IvanGrigorik/Diploma/Notes/Word/Титульный лист ДП.docx

Министерство образования Республики Беларусь

Учреждение образования

БЕЛОРУССКИЙ ГОСУДАРСТВЕННЫЙ УНИВЕРСИТЕТ

ИНФОРМАТИКИ И РАДИОЭЛЕКТРОНИКИ

Факультет компьютерных систем и сетей

Кафедра электронных вычислительных машин

| К ЗАЩИТЕ ДОПУСТИТЬ: Зав. каф. ЭВМ ___________Б.В. Никульшин

ПОЯСНИТЕЛЬНАЯ ЗАПИСКА

к дипломному проекту

на тему

АППАРАТНЫЙ КОМПЛЕКС ДЛЯ ГЕНЕРАЦИИ ШУМОВ НА ЧАСТОТАХ WI-FI И BLUETOOTH

БГУИР ДП 1–40 02 01 01 024 ПЗ

Студент Руководитель Консультанты: от кафедры ЭВМ по экономической части Нормоконтролер Рецензент | И.А. Григорик Д.В. Куприянова Д.В. Куприянова В.Г. Горовой Н.О. Туровец

МИНСК 2024
