IvanGrigorik/Diploma/Notes/Word/Титульный Лист ПДП.docx

Министерство образования Республики Беларусь

Учреждение образования

БЕЛОРУССКИЙ ГОСУДАРСТВЕННЫЙ УНИВЕРСИТЕТ

ИНФОРМАТИКИ И РАДИОЭЛЕКТРОНИКИ

Факультет компьютерных систем и сетей

Кафедра электронных вычислительных машин

Отчет по преддипломной практике

Студент И.А. Григорик

Руководитель Д.Ю. Перцев

Консультант от кафедры ЭВМ Д.В. Куприянова

Нормоконтролер Н.О. Туровец

МИНСК 2024
