IvanGrigorik/Diploma/Notes/PDF/Ведомость.pdf

Изм. Лист | | № докум. | Подп. | Дата
Разраб. | Григорик | | | Аппаратный комплекс для генерации шумов на частотах Wi-Fi и Bluetooth. Ведомость документов | Лит. | Лист | Листов
Пров. | Куприянова | | | | | У | | 1
Т. контр. | Куприянова | | | | ЭВМ, гр. 050503
Н. контр. | Туровец
Утв. | Никульшин

## БГУИР ДП 1–400201 01 024 Д1

Обозначение | Наименование | Примечание
| Графические документы
ГУИР.400201.024 ПЛ.1 | Вводный плакат. Плакат | А1
ГУИР.400201.024 ПЛ.2 | Основные определения и методы
| работы схожих устройств. Плакат | А1
ГУИР.400201.024 ПЛ.3 | Заключительный плакат. Плакат | А1
ГУИР.400201.024 Э1 ГУИР.400201.024 Э1 | Аппаратный комплекс для генерации Аппаратный комплекс для генерации
| шумов на частотах Wi-Fi и Bluetooth. шумов на частотах Wi-Fi и Bluetooth.
| Схема электрическая структурная Схема электрическая структурная | А1 А1
ГУИР.400201.024 Э2 ГУИР.400201.024 Э2 | Аппаратный комплекс для генерации Аппаратный комплекс для генерации
| шумов на частотах Wi-Fi и Bluetooth. шумов на частотах Wi-Fi и Bluetooth.
| Схема электрическая функциональная Схема электрическая функциональная | А1 А1
ГУИР.400201.024 Э3 ГУИР.400201.024 Э3 | Аппаратный комплекс для генерации Аппаратный комплекс для генерации
| шумов на частотах Wi-Fi и Bluetooth. шумов на частотах Wi-Fi и Bluetooth.
| Схема электрическая принципиальная Схема электрическая принципиальная | А1 А1
| Текстовые документы
БГУИР ДП БГУИР ДП 1–400201 01 400201 01 024ПЗ | Пояснительная записка Пояснительная записка | 96 с.
ГУИР.400201.024 ПЭ3 | Перечень элементов | 2 л., в ПЗ
ГУИР.400201.024 Э4 | Аппаратный комплекс для генерации
| шумов на частотах Wi-Fi и Bluetooth.
| Чертёж электромонтажный | А4, в ПЗ
| Аппаратный комплекс для генерации
| шумов на частотах Wi-Fi и Bluetooth.
| Чертёж электромонтажный.
| Спецификация | 1 л., в ПЗ
| Отзыв руководителя
| Отчет проверки на заимствования | 2 л.
| Рецензия
