IvanGrigorik/Diploma/Notes/PDF/Спецификация.pdf

Изм. Лист | | № докум. | Подп. | Дата
Разраб. | Григорик | | | Аппаратный комплекс для генерации шумов на частотах Wi-Fi и Bluetooth. Спецификация | Лит. | Лист | Листов
Пров. | Куприянова | | | | | У | | 1
Т. контр. | Куприянова | | | | ЭВМ, гр. 050503
Н. контр. | Туровец
Утв. | Никульшин

## ГУИР.400201.024 Д2

Обозначение | Наименование | Примечание
| Документация
51-01 | Программа и методика
| испытаний | В составе пояснительной записки
81-01 | Пояснительная записка

Компоненты
BOM.csv
Производственный файл | На DVD-R диске «Ваня»
Gerber.zip
Производственный файл | На DVD-R диске «Ваня»
Modules_modeling.asc
Тестовый файл | На DVD-R диске «Ваня»
PickAndPlace.csv
Производственный файл | На DVD-R диске «Ваня»
Presentation.pptx
Мультимедийный файл | На DVD-R диске «Ваня»
Proof.mp4
Мультимедийный файл | На DVD-R диске «Ваня»

Обозначение | Наименование | Примечание
| folder_header/filename11.h.
| Заголовочный файл | На DVD-R диске «название диска»
| filename12.exe.
| Исполняемый файл | На DVD-R диске «название диска»
| Презентация.pptx
| Мультимедийный файл | На DVD-R диске «название диска»
| readme.txt.
| Текстовый файл | На DVD-R диске «название диска»
| folder_cpp/filename13.cpp.
| Файл с исходными текстами | На DVD-R диске «название диска»
| folder_cpp/filename14.cpp.
| Файл с исходными текстами | На DVD-R диске «название диска»
| folder_cpp/filename15.cpp.
| Файл с исходными текстами | На DVD-R диске «название диска»
| folder_cpp/filename16.cpp.
| Файл с исходными текстами | На DVD-R диске «название диска»
| folder_cpp/filename17.cpp.
| Файл с исходными текстами | На DVD-R диске «название диска»
| folder_cpp/filename18.cpp.
| Файл с исходными текстами | На DVD-R диске «название диска»
| folder_cpp/filename19.cpp.
| Файл с исходными текстами | На DVD-R диске «название диска»
| folder_cpp/filename20.cpp.
| Файл с исходными текстами | На DVD-R диске «название диска»
Изм. Лист | № докум. | Подп. | Дата

## ГУИР.400201.YYY Д2

Лист
2
