IvanGrigorik/Diploma/Notes/PDF/Перечень элементов.pdf

Изм. Лист | | № докум. | Подп. | Дата
Разраб. | Григорик | | | Аппаратный комплекс для генерации шумов на частотах Wi-Fi и Bluetooth. Перечень элементов | Лит. | Лист | Листов
Пров. | Куприянова | | | | | У | | 1 | 2
Т. контр. | Куприянова | | | | ЭВМ, гр. 050503
Н. контр. | Туровец
Утв. | Никульшин
Поз. обозна-чение | Наименование | | Примечание
| Конденсаторы
C1,С8 C1,С8 | Конденсатор многослойный 10 нФ 250 В Конденсатор многослойный 10 нФ 250 В
| ±10% X7R ±10% X7R | 2 2
C2, C5, | Конденсатор многослойный 100 нФ 50 В
C7 | ±10% X7R | 3
С3, С9, | Конденсатор многослойный 47 нФ 50 В ±10%
С10 | X7R | 3
C4 | Конденсатор многослойный 22 мкФ 25 В
| ±20% X7R | 1
C6 | Конденсатор многослойный 100 пФ 50 В
| ± 5% C0G | 1
С11 | Конденсатор многослойный 10.5 пФ 50 В
| ± 5% NP0 | 1

Зона
Кол.
| Микросхемы
BMS | HX-2S-JH20, система управления батареи | 1
DC-DC | XL6009, преобразователь, повышающий | 1
FAN | RQU3510MS, вентилятор-улитка, 0.15 А,
| 0.75 Вт, 7000 об./мин. | 1
LVC | LM2940L-50-TN3-R, линейный регулятор
| напряжения | 1
VCO | YSGM232508, генератор управляемый
| напряжением | 1
VD | 0805G, светодиод зелёный 120° 100 мКд
| 474 нм | 1
| Резисторы
R1 | Терморезистор 22 кОм, 0.5 Вт, ±2% | 1
R2, R5 | Резистор SMD 22 кОм, 0.125 Вт, ±1% | 2
| | | ГУИР.400201.024 ПЭ3

Изм. Лист | № докум. | Подп. | Дата

## ГУИР.400201.024 ПЭ3

Поз. обозна-чение | Наименование | | Примечание
R3, R6 | Резистор SMD 1 кОм, 0.25 Вт, ±1%
R8 | | 3
R4, R11 | Резистор SMD 150 Ом, 0.5 Вт, ±5% | 2
R7 | Резистор SMD 100 Ом, 1 Вт, ±5% | 1
R9, R10 Резистор подстроечный 1 кОм, 0.5 Вт,
| ±10% | 2

Зона
Кол.

Лист
2
| Аккумуляторы
B1...B2 B1...B2 | EVE-ICR18650/26V аккумулятор литий-EVE-ICR18650/26V аккумулятор литий-
| ионный, 2550 мАч, 7.65 А ионный, 2550 мАч, 7.65 А | 2 2
| Разъемы
RF-SMA | KH-SMA-K513-G, RF-вывод на SMA-антенну
| шаг 2.54мм, 5 контактов | 1
USB-C | GT-USB-7010ASV, USB 2.0 type-C female,
| крепление на плату | 1
| Транзисторы
VT1...VT4 MMBT2222A, MMBT2222A, NPN-Транзистор, Транзистор, 50 В, 0.8 A | | 4
