IvanGrigorik/Diploma/Notes/PDF/Структурная.pdf

# Модуль развязки

# Модуль RF-вывода

# Модуль источника питания

# Модуль импульсного генератора

# Модуль регулирования питания

# Модуль настройки импульсов

Модуль генератора,

# управляемого напряжением

Модуль генератора,

# управляемого импульсами

| | | | | ГУИР.400201.024 Э1 ГУИР.400201.024 Э1
| | | | | Аппаратный комплекс для Аппаратный комплекс для генерации шумов на частотах генерации шумов на частотах Wi-Fi и Bluetooth. Wi-Fi и Bluetooth. Схема электрическая Схема электрическая структурная структурная | Лит. Лит. | Масса Масса | Масштаб Масштаб
Изм. Лист Изм. Лист | | № докум. № докум. | Подп. Подп. | Дата Дата | | | У У
Разраб. Разраб. | | Григорик Григорик
Пров. Пров. | | Куприянова Куприянова
Т. контр. Т. контр. | Куприянова Куприянова | | | | Лист Лист | Листов Листов 1 1
Реценз. Реценз. | | | | | ЭВМ, гр. 050503 ЭВМ, гр. 050503
Н. контр. Н. контр. | Туровец Туровец
Утв. Утв. | Никульшин Никульшин
