IvanGrigorik/Diploma/Additional_Files/Formula.png

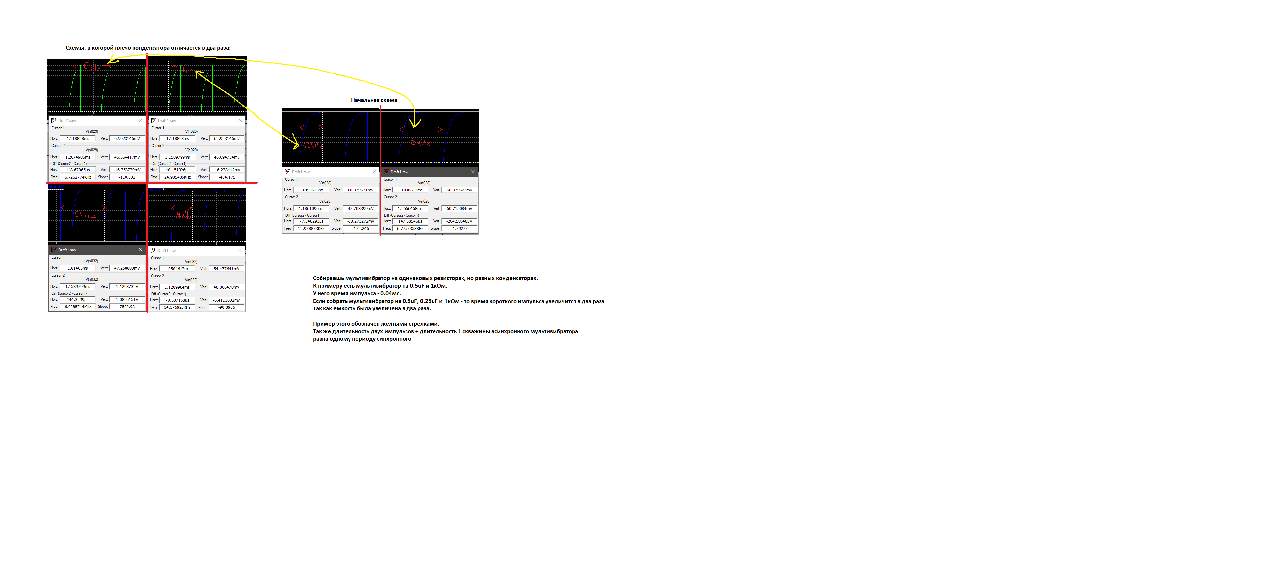
Additional_Files/Formula.png
