IvanGrigorik/Diploma/JLCPCB/BOM_2024-04-25_one_layer_basic.csv

ID | Name | Designator | Footprint | Quantity | Manufacturer Part | Manufacturer | Supplier | Supplier Part | Price | Pins | 3DModel | Contributor | JLCPCB Part Class | link
1 | 150Ω | R1,R4 | R0805 | 2 | AS05W2J0151T5E | UNI-ROYAL(厚声) | LCSC | C560494 | 0.019 | 2 | R0805_L2.0-W1.3-H0.6 | LCSC | Extended Part | https://item.szlcsc.com/142685.html
2 | 100Ω | R6 | R2512 | 1 | 25121WJ0101T4E | UNI-ROYAL(厚声) | LCSC | C24920 | 0.016 | 2 | R2512_L6.3-W3.2-H0.6 | lcsc | Extended Part | https://item.szlcsc.com/347967.html
3 | KH-SMA-K513-G | RF | ANT-TH_KH-SMA-K513-G | 1 | KH-SMA-K513-G | kinghelm(金航标) | LCSC | C411575 | 0.504 | 5 | ANT-TH_L14.8-W6.4-H10.0 | LCSC | Extended Part | https://item.szlcsc.com/402832.html
4 | LM2940L-50-TN3-R | U1 | TO-252-2_L6.6-W6.1-P4.57-LS9.9-TL-CW | 1 | LM2940L-50-TN3-R | UTC(友顺) | LCSC | C85225 | 0.291 | 3 | TO-252-2L-3P_L6.6-W6.1-H2.3-LS10.1-P4.6 | lcsc | Extended Part | https://item.szlcsc.com/176608.html
5 | 1.5pF | C11 | C0402 | 1 | CC0402BRNPO9BN1R5 | YAGEO(国巨) | LCSC | C282238 | 0.002 | 2 | C0402_L1.0-W0.5-H0.5 | LCSC | Extended Part | https://item.szlcsc.com/15869.html
6 | 10nF | C1,C9 | C0805 | 2 | CL21B103KBANNNC | SAMSUNG(三星) | LCSC | C1710 | 0.006 | 2 | C0805_L2.0-W1.3-H1.3 | lcsc | Basic Part | https://item.szlcsc.com/373011.html
7 | 47nF | C2,C7,C6 | C0805 | 3 | CL21B473KBCNNNC | SAMSUNG(三星) | LCSC | C53134 | 0.01 | 2 | C0805_L2.0-W1.3-H1.3 | lcsc | Basic Part | https://item.szlcsc.com/373011.html
8 | 100nF | C3,C10,C4 | C0603 | 3 | CC0603KRX7R9BB104 | YAGEO(国巨) | LCSC | C14663 | 0.002 | 2 | C0603_L1.6-W0.8-H0.8 | lcsc | Basic Part | https://item.szlcsc.com/362304.html
9 | 100pF | C5 | C0805 | 1 | CL21C101JBANNNC | SAMSUNG(三星) | LCSC | C1790 | 0.009 | 2 | C0805_L2.0-W1.3-H1.3 | lcsc | Basic Part | https://item.szlcsc.com/373011.html
10 | 22uF | C8 | C0805 | 1 | CL21A226MAQNNNE | SAMSUNG(三星) | LCSC | C45783 | 0.023 | 2 | C0805_L2.0-W1.3-H1.3 | lcsc | Basic Part | https://item.szlcsc.com/373011.html
11 | MMBT2222A_C8512 | Q1,Q2,Q3,Q4 | SOT-23-3_L2.9-W1.3-P1.90-LS2.4-BR | 4 | MMBT2222A 1P | CJ(江苏长电/长晶) | LCSC | C8512 | 0.017 | 3 | SOT-23-3P_L2.9-W1.3-H1.0-LS2.4-P0.95 | lcsc | Basic Part | https://www.diodes.com/assets/Package-Files/SOT23.pdf
12 | 1kΩ | R2,R3,R9 | R1206 | 3 | 1206W4F1001T5E | UNI-ROYAL(厚声) | LCSC | C4410 | 0.003 | 2 | R1206_L3.2-W1.6-H0.6 | lcsc | Basic Part | https://item.szlcsc.com/311874.html
13 | 22kΩ | R5,R7 | R0805 | 2 | 0805W8F2202T5E | UNI-ROYAL(厚声) | LCSC | C17560 | 0.002 | 2 | R0805_L2.0-W1.3-H0.6 | lcsc | Basic Part | https://item.szlcsc.com/142685.html
14 | HDR-M-2.54_1x2 | 5_OUT,FAN_OUT,7.4_IN | HDR-M-2.54_1X2 | 3 |  |  | LCSC | C124375 | 0.022 | 2 | HDR-M-2.54_1x2 | LCEDA_Lib
15 | 0805G (Green) | LED1 | LED0805-R-RD | 1 | KT-0805G | KENTO | LCSC | C2297 | 0.013 | 2 | LED0805-RD | lcsc | Basic Part | https://item.szlcsc.com/88042.html
16 | GT-USB-7010ASV | U2 | USB-C-SMD_G-SWITCH_GT-USB-7010ASV | 1 | GT-USB-7010ASV | G-Switch(品赞) | LCSC | C2988369 | 0.074 | 16 | USB-C-SMD_G-SWITCH_GT-USB-7010ASV | lcsc | Extended Part | https://atta.szlcsc.com/upload/public/pdf/source/20220407/8043DBBC37E1BDE9D4FD36EE7A4A9BB9.pdf
