IvanGrigorik/Diploma/JLCPCB/BOM_2024-04-22.csv

ID | Name | Designator | Footprint | Quantity | Manufacturer Part | Manufacturer | Supplier | Supplier Part | Price | Pins | 3DModel | JLCPCB Part Class | Resistance(Ohms)
1 | 150Ω | R1,R4 | R0805 | 2 | AS05W2J0151T5E | UNI-ROYAL(厚声) | LCSC | C560494 | 0.019 | 2 | R0805_L2.0-W1.3-H0.6 | Extended Part
2 | 1kΩ | R2,R3,RX | R2010 | 3 | WR20X1001FTL | Walsin(华新科) | LCSC | C335021 | 0.017 | 2 | R2010_L5.0-W2.5-H0.6 | Extended Part
3 | 22KΩ | R8 | RES-TH_L6.0-W3.0-P2.54-D0.6 | 1 | NTCLE100E3223JB0 | VISHAY(威世) | LCSC | C144942 | 0.474 | 2 | RES-TH_L6.0-W3.0-H8.0-P2.54-D0.6 | Extended Part
4 | 10nF | C1,C9 | C1206 | 2 | C1206X103K501T | IHHEC(禾伸堂) | LCSC | C106022 | 0.019 | 2 | C1206_L3.2-W1.6-H1.3 | Extended Part
5 | 100nF | C3,C5,C10 | C1206 | 3 | 1206B104K250CT | Walsin(华新科) | LCSC | C396778 | 0.012 | 2 | C1206_L3.2-W1.6-H1.3 | Extended Part
6 | 47nF | C2,C4,C7 | C0603 | 3 | FP18X473K500PBG | PSA(信昌电陶) | LCSC | C525319 | 0.008 | 2 | C0603_L1.6-W0.8-H0.8 | Extended Part
7 | MMBT2222A_C171740 | Q1,Q2,Q3 | SOT-23-3_L2.9-W1.3-P1.90-LS2.4-BR | 3 | MMBT2222A | SHIKUES(时科) | LCSC | C171740 | 0.012 | 3 | SOT-23-3P_L2.9-W1.3-H1.0-LS2.4-P0.95 | Extended Part
8 | 22kΩ | R5,R7 | R0805 | 2 | RK73B2ATTD223J | KOA | LCSC | C316792 | 0.005 | 2 | R0805_L2.0-W1.3-H0.6 | Extended Part
9 | 100Ω | R6 | R2512 | 1 | 25121WJ0101T4E | UNI-ROYAL(厚声) | LCSC | C24920 | 0.016 | 2 | R2512_L6.3-W3.2-H0.6 | Extended Part
10 | BS2P-SHF-1AA-(LF)(SN) | 7.4V_IN,5V_OUT,FAN_OUT | CONN-TH_BS2P-SHF-1AA-LF-SN | 3 | BS2P-SHF-1AA(LF)(SN) | JST | LCSC | C161707 | 0.101 | 2 | CONN-TH_BS2P-SHF-1AA-LF-SN | Extended Part
11 | 22uF | C8 | C1206 | 1 | LMK316B7226KL-TR | TAIYO YUDEN(太诱) | LCSC | C555367 | 0.081 | 2 | C1206_L3.2-W1.6-H1.3 | Extended Part
12 | 100pF | C6 | C0603 | 1 | CGA3E2C0G2A101JT0Y0N | TDK | LCSC | C342908 | 0.014 | 2 | C0603_L1.6-W0.8-H0.8 | Extended Part
13 | 1.5pF | C11 | C0201 | 1 | 0201N1R5C250CT | Walsin(华新科) | LCSC | C424820 | 0.002 | 2 | C0201_L0.6-W0.3-H0.3 | Extended Part
14 | KH-SMA-K513-G | RF | ANT-TH_KH-SMA-K513-G | 1 | KH-SMA-K513-G | kinghelm(金航标) | LCSC | C411575 | 0.494 | 5 | ANT-TH_L14.8-W6.4-H10.0 | Extended Part
15 | 1kΩ | RP1,RP2 | RES-ADJ-TH_3362X | 2 | 3362X-1-102LF | BOURNS | LCSC | C123857 | 0.225 | 3 | RES-ADJ-TH_3362X | Extended Part | 1K
16 | LM2940L-50-TN3-R | U1 | TO-252-2_L6.6-W6.1-P4.57-LS9.9-TL-CW | 1 | LM2940L-50-TN3-R | UTC(友顺) | LCSC | C85225 | 0.291 | 3 | TO-252-2L-3P_L6.6-W6.1-H2.3-LS10.1-P4.6 | Extended Part
17 | GT-USB-7010ASV | U2 | USB-C-SMD_G-SWITCH_GT-USB-7010ASV | 1 | GT-USB-7010ASV | G-Switch(品赞) | LCSC | C2988369 | 0.074 | 16 | USB-C-SMD_G-SWITCH_GT-USB-7010ASV | Extended Part
