IvanGrigorik/Diploma/(list of files, cad)

Other CAD files:
AutoCAD/Intro.dwg
AutoCAD/Schematic.dwg
