IvanGrigorik/Diploma/Notes/PDF/Заключительный плакат.pdf

# Аппаратный комплекс генерации шумов на частотах Wi-Fi и Bluetooth

## Результаты исследований:

Была проанализирована теоретическая часть, связанная с шумами сигналов и способами генерации данных шумов, в результате чего был разработан рабочий макет устройства.

## Практический и теоретический результат генерации шумов непосредственного влияния:

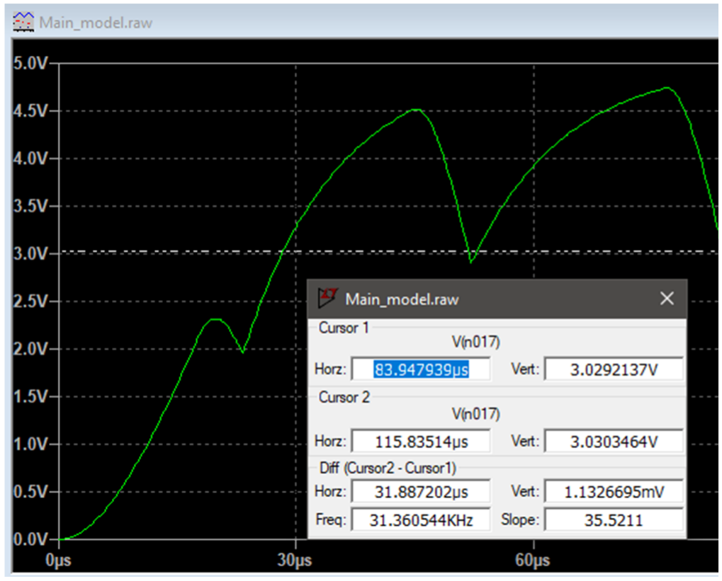
[picture p34: figure]

## Результат работы и макет устройства:

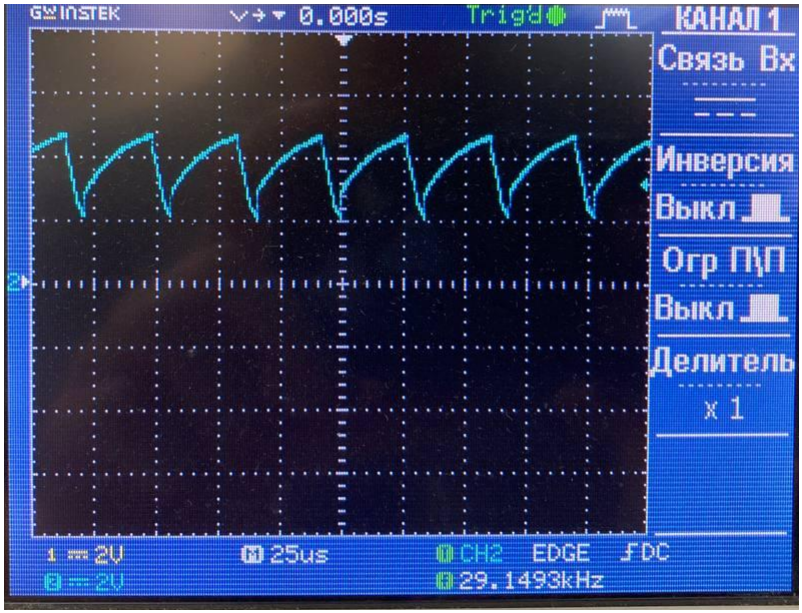
[picture p35: figure]
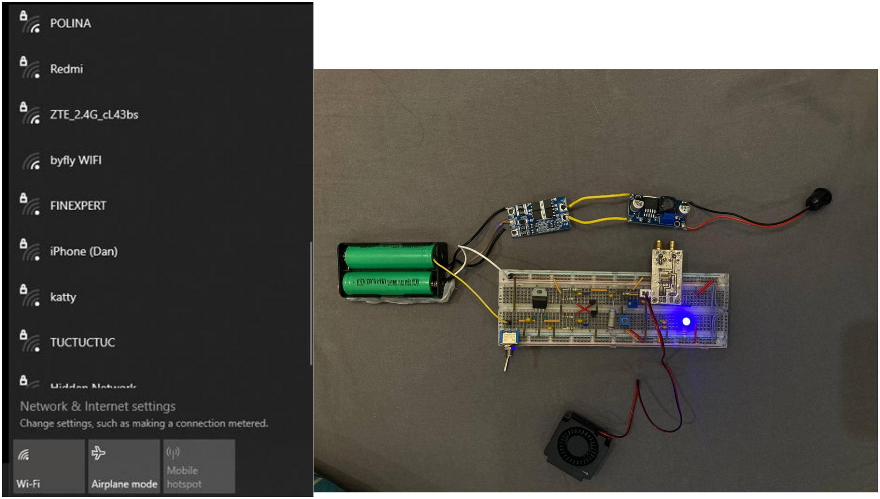
[picture p36: figure]

## Вывод:

В результате тщательного анализа протоколов 802.11 и 802.15 были выявлены недостатки, которые можно использовать для перебоев связи между устройствами, из которых были определены ключевые характеристики данного аппаратного комплекса.

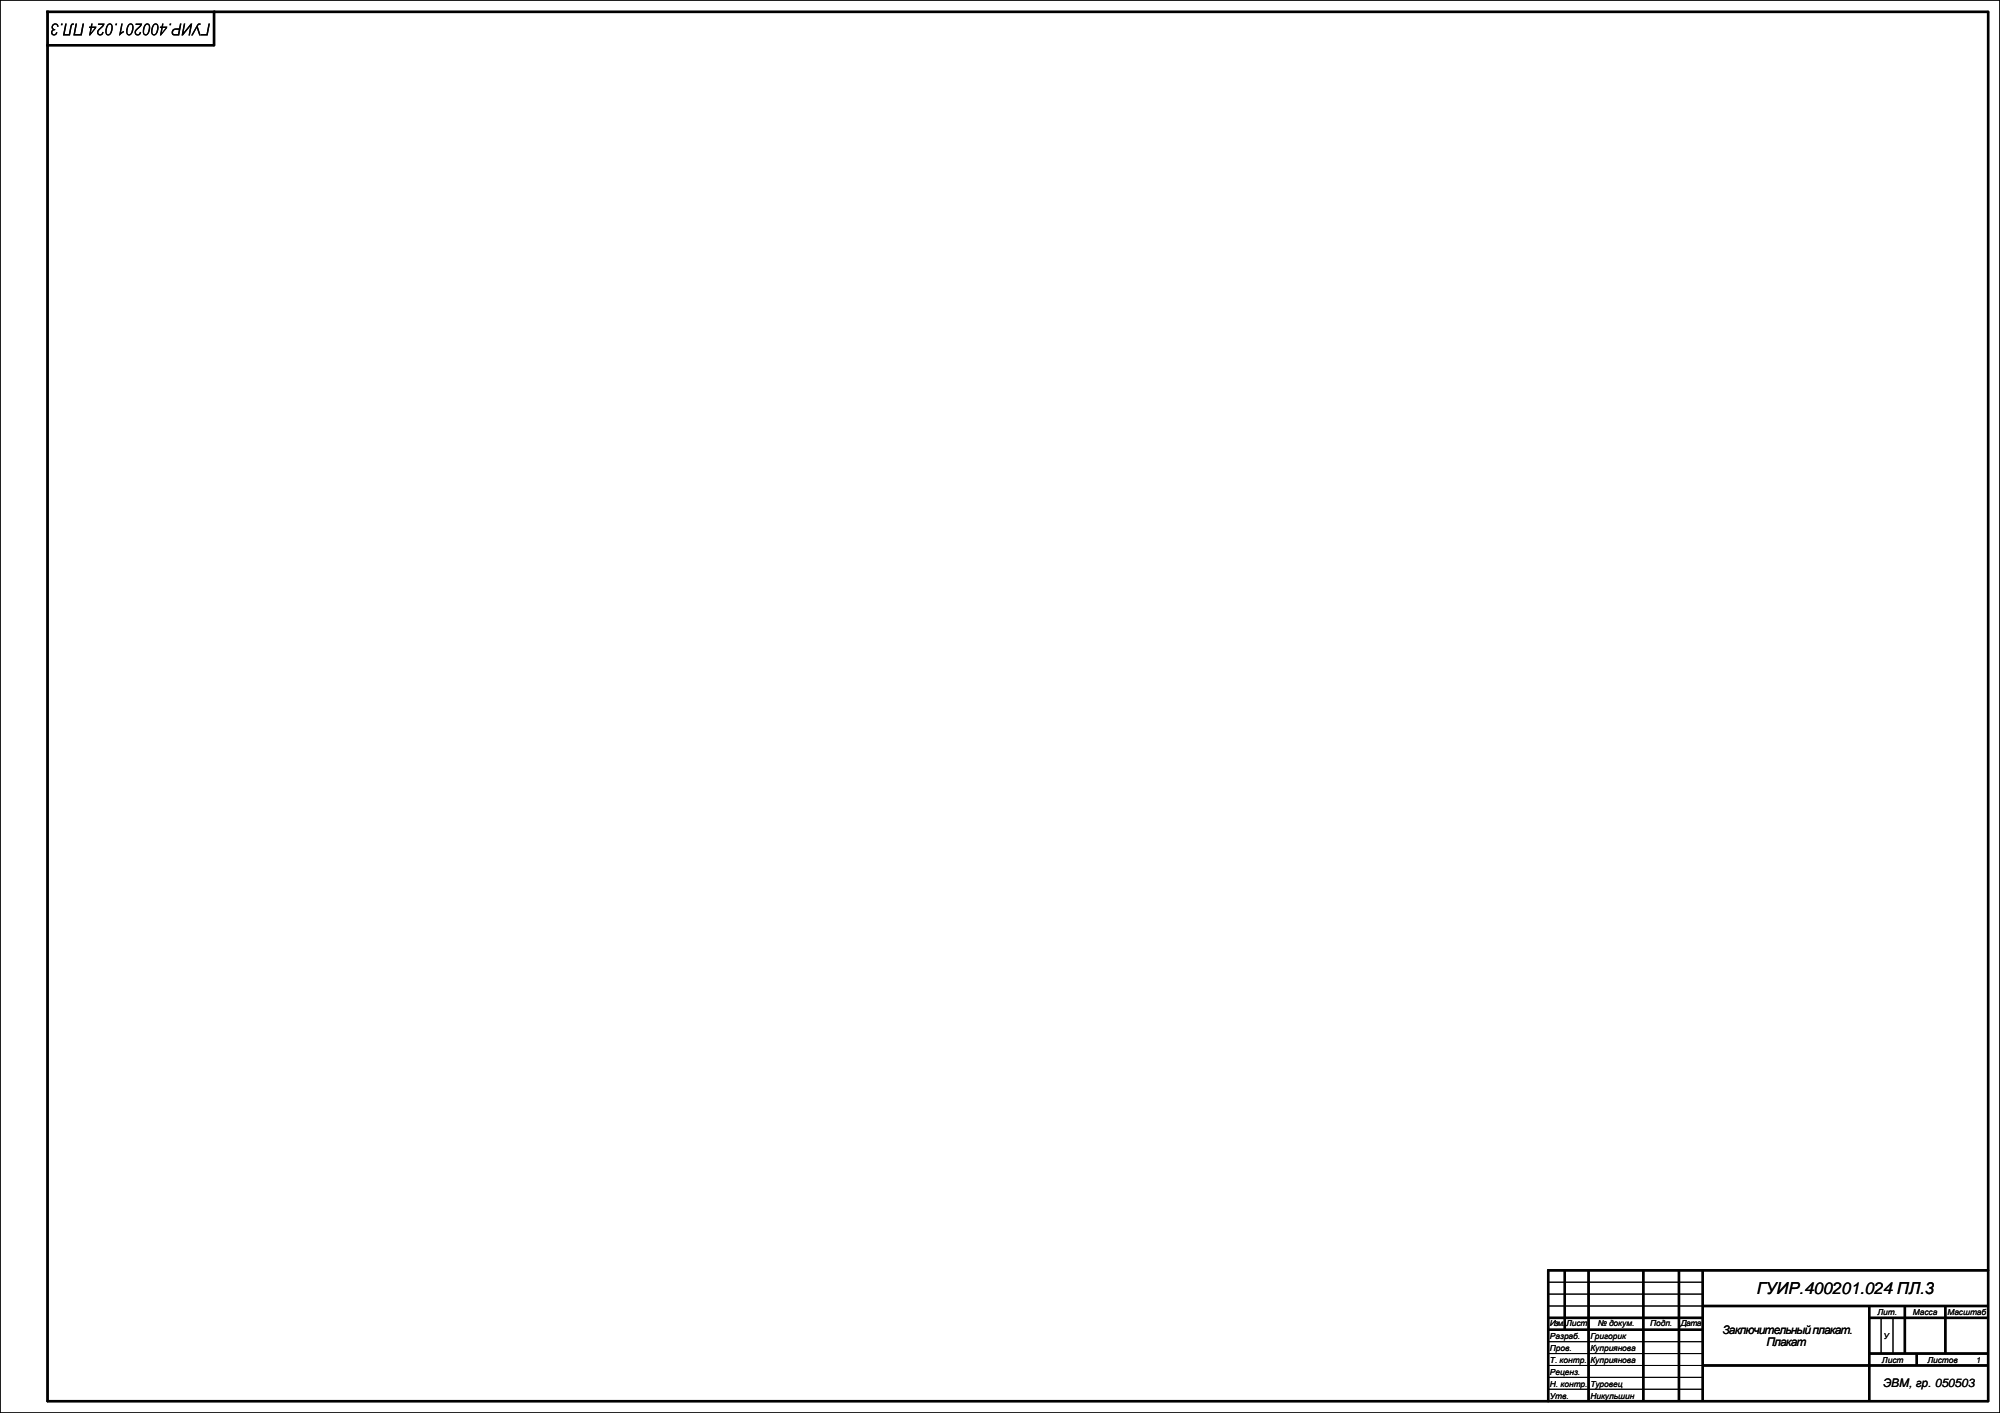
[picture p37: page 2]

ГУИР.400201.024 ПЛ.3

Заключительный плакат. Заключительный плакат. Плакат Плакат | Лит. | Масса | Масштаб

Изм. Лист | | № докум. | Подп. | Дата | | | У У
Разраб. | | Григорик
Пров. | | Куприянова
Т. контр. | Куприянова | | | | Лист | Листов Листов 1 1
Реценз. | | | | | ЭВМ, гр. 050503
Н. контр. | Туровец
Утв. | Никульшин
