IvanGrigorik/Diploma/Notes/PDF/Пояснительный плакат.pdf

# Основные определения и методы работы схожих устройств

## Ключевые определения:

– тайм-слот конкретной технологии напрямую влияет на частоту
работы устройства;
– основной способ подавления сигнала – генерация сигналов на диапазоне частот, схожим с диапазоном конкретной технологии (шумы непосредственного влияния;
– альтернативные способы – выбор конкретной частоты для подавления и генерация шумов за счёт гармоник (дороже и зачастую менее эффективно).

## Ключевые понятия:

– тайм-слот – наименьшая единица разделения канала в беспроводных сетях, назначенная конкретному пользователю (не путать с проводными сетями); – SNR (Signal to Noise Ratio) – отношение сигнала к шуму, которое определяет будет ли полезный сигнал различим от шумового или нет;
– THD (Total Harmonic Distortion) – искажение, оказываемое гармоникой на основной сигнал.

## Шумы непосредственного влияния

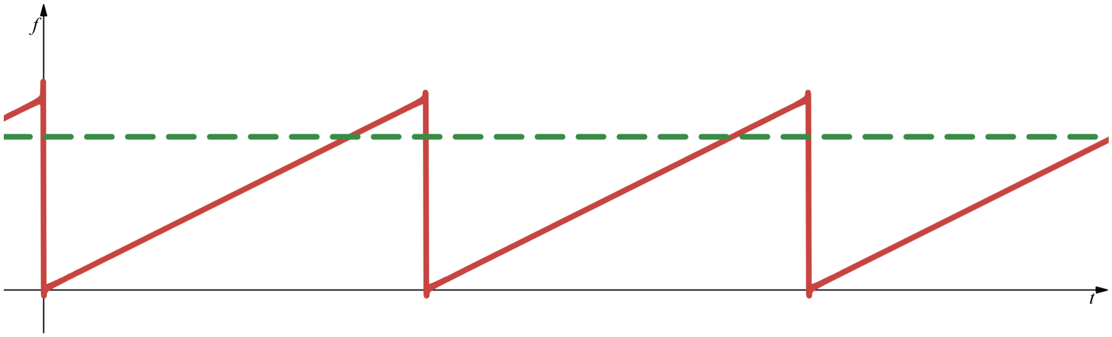
[picture p38: figure]

## Гармонические шумы

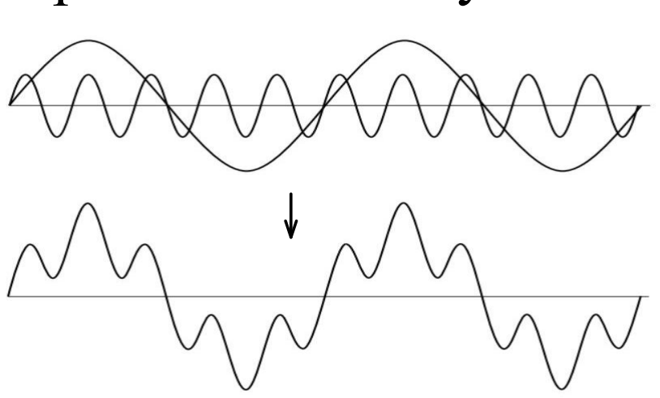
[picture p39: figure]

Частоты генераторов,

## управляемых напряжением:

## Схожие методы:

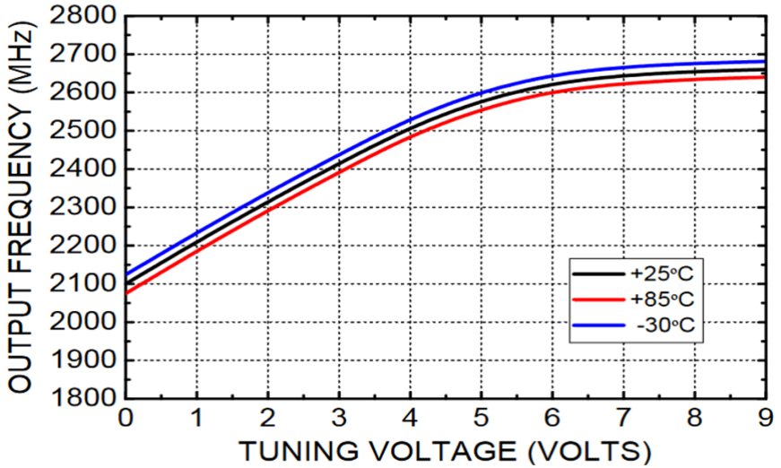
[picture p40: figure]

– на массовых мероприятиях при большом количестве людей; – два маршрутизатора работают на одинаковых частотах рядом друг с другом;
– усилители сигнала перебивают частоты соседних устройств.

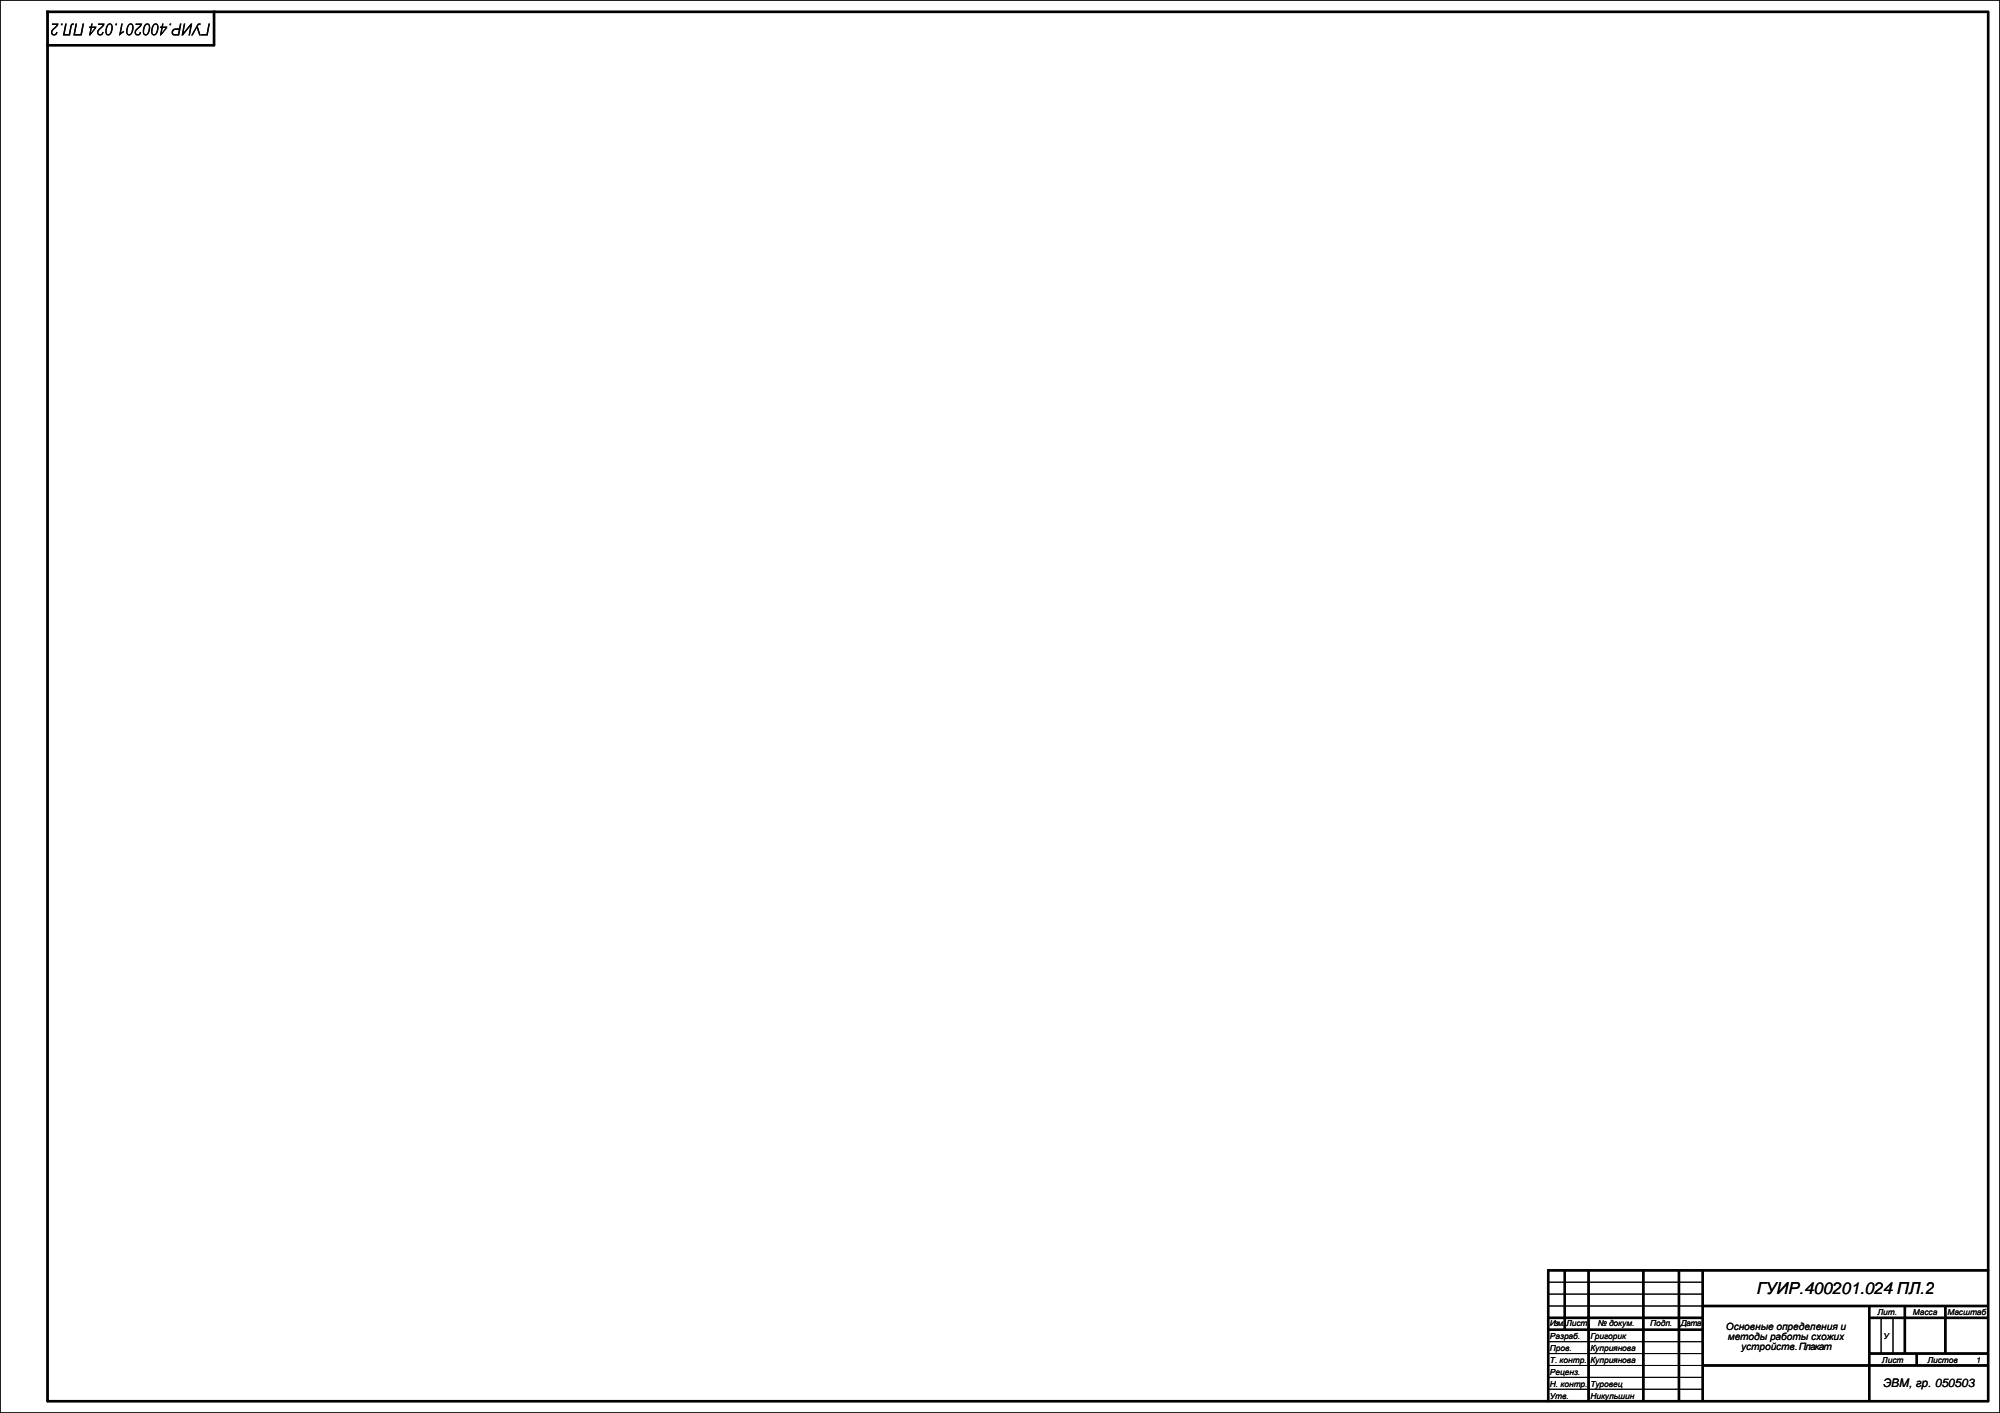
[picture p41: page 2]

ГУИР.400201.024 ПЛ.2

Основные определения и Основные определения и методы работы схожих методы работы схожих устройств. Плакат устройств. Плакат | Лит. | Масса | Масштаб

Изм. Лист | | № докум. | Подп. | Дата | | | У У
Разраб. | | Григорик
Пров. | | Куприянова
Т. контр. | Куприянова | | | | Лист | Листов Листов 1 1
Реценз. | | | | | ЭВМ, гр. 050503
Н. контр. | Туровец
Утв. | Никульшин
