IvanGrigorik/Diploma/(commit log)

2024-03-12 Initialize directory
    [Book1.xlsx]
2024-03-28 Add test ltspice, schematics and other
    [Book1.xlsx, Schematic.dwg]
2024-03-30 Fix from reviewer
    [Book1.xlsx, Schematic.dwg]
2024-03-30 Add intro
    [Intro.dwg, Schematic.dwg]
2024-04-07 add intro schematic
    [Intro.dwg, Schematic.dwg]
2024-04-10 Add struct schematic
2024-04-11 Reviewer fix
    [Book1.xlsx]
2024-04-12 Add important chapter part
    [Book1.xlsx]
2024-04-15 Add part of the 3rd chapter
    [Book1.xlsx]
2024-04-16 Add economics chapter
    [Book1.xlsx]
2024-04-17 Add economic chapter
    [Book1.xlsx]
2024-04-17 Add schematic and finish functional chapter review'
2024-04-30 Start chapter 4
    [BOM_2024-04-22.csv, BOM_2024-04-25.csv, BOM_2024-04-25_one_layer.csv, BOM_2024-04-25_one_layer_basic.csv, Book1.xlsx, PickAndPlace_2024-04-22.csv, PickAndPlace_2024-04-25.csv, PickAndPlace_2024-04-25_one_layer.csv]
2024-05-16 Add final features
    [BOM_Diploma_2024-05-15.csv, PickAndPlace_Diploma_2024-05-15.csv]
2024-06-17 Add final files
    [Book1.xlsx]
